thejosephloy/EKG/README.md

# EKG
Processing Code for bread board EKG using band pass filter and instrumentation amplifier
